AVHon/toolTube/README.md

Similar to tubes sold by
[McMaster-Carr](https://www.mcmaster.com/shipping-tubes/shape~round-tube/material~plastic/end-caps-included~yes/)
or
[Rose Lite Packaging](https://roselitepackaging.us/shop/plastic-tubes/adjustable-length-round-tubes)
.

If you clone this repository, don't forget to
`git submodule update --init --recursive`
to pull the [roundedRegularPolygon](https://github.com/AVHon/roundedRegularPolygon)
module that this project depends on.
