AVHon/toolTube/(commit log)

2020-07-10 Init: rounded polygons good, but tubes don't fit
    [RoundedRegularPolygon.scad, toolTube.scad]
2020-07-10 create thread profile as a module
    [toolTube.scad]
2020-07-10 only create inner tube
    [toolTube.scad]
2020-07-10 factor out tab_column; use OD; don't use radius
    [toolTube.scad]
2020-07-10 discard nonsense calculation of tab height
    [toolTube.scad]
2020-07-10 calculate tab heights using start<end range
    [toolTube.scad]
2020-07-10 factor out making of a tab
    [toolTube.scad]
2020-07-10 make threads fill whole surface
    [toolTube.scad]
2020-07-10 modularize inner part; make tabs not intercect cap
    [toolTube.scad]
2020-07-10 remove commented-out outer part
    [toolTube.scad]
2020-07-10 make outer part; TODOs might be done(!)
    [toolTube.scad]
2020-07-10 improve style; remove unnecessary lines
    [toolTube.scad]
2020-07-10 use a cube for the thread profile
    Rather than use 2 cones for the profile,
    use one cube turned up on its corners.
    This involves some tricky trigonometry
    to get the exact values of everything,
    but it is all angles and lengths on the
    unit cube.
    Upsides:
    * fewer lines of code
    * don't need to reset $fn
    * don't need to make 2 cones
    * assymetric angles
    * easier to put on
    * harder to fall off
    Downsides:
    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
    [toolTube.scad]
2020-07-10 flip thread direction on outer part
    [toolTube.scad]
2020-07-10 use approximations of trig values
    [toolTube.scad]
2020-07-10 do away with modifying $fn
    let it be the default,
    and round the roundedPolygon based on $fa
    [toolTube.scad]
2020-07-10 get the threads the right way around
    Argh, it must be too late/early. 7AM...
    [toolTube.scad]
2020-07-10 get the threads the right way again
    [toolTube.scad]
2020-07-10 remove all sets to $fn
    since it isn't necessary anymore.
    However, do respect it in non-cylinder parts
    in case somebody sets it and expects it to work.
    [toolTube.scad]
2020-07-10 refer to 'Thread' where correct
    [toolTube.scad]
2020-07-10 use list comprehension for making thread hulls
    The list comprehension is a more compact and more
    explicit way of generating the pairs of angles for
    each pair of hulled thread profiles.
    [toolTube.scad]
2020-07-10 use exact and eas[y|ier] trig for thread profile
    I learned about resize()!
    Rather than having to use trig, or magic numbers,
    to scale the cube to the right size, I can just
    resize it to whatever size I want! Much better!
    Since most trig is gone, and the result will now
    be exact, I decided to re-add the trig for rotating
    the cube to the right orientation. It's just one bit
    of trig, and it makes the whole thing come out exact.
    Also, since resize() scales the diameter, rather than
    the radius, I changed the comments and math in the
    constants section to reference the thread profile's
    diameter (id/15) rather than its radius (id/30).
    [toolTube.scad]
2020-07-10 use rotate([0,180]) instead of scale([-1,1,-1])
    For my purposes, rotating does the same thing,
    and its much easier to visualize than the scaling.
    [toolTube.scad]
2020-07-10 only use 1 cylinder (a cone) in the cap
    I realized that I was hull()ing two super-flat
    cylinders together, as though they were circles,
    and that I ought to just make a cylinder out of
    the two of them.
    [toolTube.scad]
2020-07-10 account for thickness of 3D-printed walls
    Haven't actually done this yet, even though
    it is vital to get the parts to actually work,
    and I think it is done and was easy to do.
    [toolTube.scad]
2020-07-10 clarify how thread pitch is calculated
    Technically, thread pitch should be calculated
    as a function of turns per axial length. Maybe
    I should switch to that in the future. In the
    meanwhile, the pitch angle works fine, but I felt
    I should not that it is calculated as a pitch
    when wrapped around the inside diameter.
    [toolTube.scad]
2020-07-10 allow Rounded Polygons to use $fa
    The number of sides will *always* be >= n
    If $fn is set, that will be used to make the poly
    If $fn is not set, $fa/360 will be used
    [RoundedRegularPolygon.scad]
2020-07-10 remove $fn and $fa from rounded polygon call
    Rounded Regular Polygon is now smart enough that
    it doesn't need to be given n.
    [toolTube.scad]
2020-07-10 Don't use maximum length, just use tube length
    Originally, ml would be the longest thing the tube
    could hold, and the 2 halves would be ml/2 long.
    The cap would add enough extra length for the two
    parts to overlap.
    The only thing that was done with ml was to divide
    id by 2 to get part height. Everything else was done
    with ph. So just use that, and rename it as Tube Length.
    [toolTube.scad]
2020-07-10 rename `Tube Length` to `Part Length`
    It was confusing for names starting with `t`
    to refer to both `Thread` and `Tube`.
    Now `Part` has the monopoly on the `p` prefix.
    [toolTube.scad]
2020-07-10 define origin of cap at bottom of cap
    Previously, the cap's origin was on its top face.
    Now that it is on the bottom, it can be built up
    more intuitively (fewer negatives, up from bottom)
    and also in fewer lines.
    [toolTube.scad]
2020-07-10 prioritize Part Length over Wall Thickness
    For people using this in the future, the length
    of the tubes is probably more interesting than
    the calculated wall thickness. Move it to be
    higher on the list of parameters.
    [toolTube.scad]
2020-07-10 move `nt` into tab_column()
    `nt` is the number of tabs in a column,
    and only the function that makes columns needs
    to know that.
    [toolTube.scad]
2020-07-10 fix comment: thread profile no longer approximate
    For a while, the thread profile was calculated with
    magic numbers which were rounded trig numbers
    calculated from the actual cube used for the
    profile.
    Now that the profile is made with the cube, an
    accurate call to rotate(), and resize(), it is no
    longer an approximation.
    [toolTube.scad]
2020-07-10 move inner tube up to floor
    Place the inner tube on the same level os the
    outer tube, with its lowest point at z=0.
    This may make a difference for some slicers.
    [toolTube.scad]
2020-07-10 get cap size with d=diamater, not r=diameter/2
    Mild oversight on my part, I forgot you could
    make cylinders with d1=x and d2=y, and I used
    r1=x/2 and r2=y/2 instead.
    [toolTube.scad]
2020-07-10 CAPITALIZE input parameters; they are like conts
    Other variables are calculated from them, but the
    parameters are by the user and not messed with.
    Capitalize them to clarify their role.
    [toolTube.scad]
2020-07-10 correct capitalization of variable names in comments
    [toolTube.scad]
2020-07-10 factor number of tabs per column to only call
    `nt` was calculated with other global variables,
    but it is only used by tab_column, which is only
    called by inner(). Moved the calculation inline
    to the call.
    [toolTube.scad]
2020-07-10 no more tabs, only threads
    It was only going to be confusing.
    Now that there is no tab_column,
    there might as well be nothing called "tabs".
    It's more correct anyway to call them "threads".
    [toolTube.scad]
2020-07-10 make outer spiral pitch from th, not tr
    This paves the way for making the thread pitch a
    parameter, calculating thread rise per degree in
    thread(), and removing some redundant trig.
    [toolTube.scad]
2020-07-10 threads are spirals. "spiral of threads"=confusing
    [toolTube.scad]
2020-07-10 use thread height instead of thread slope
    Using the height (or pitch) simplifies the
    geometry calculations and makes things more
    consistent.
    [toolTube.scad]
2020-07-10 lowercase names are nicer; move OD declaration
    UPPERCASE was getting annoying to look at.
    Also, after the geometry simplification, the only
    global variable that isn't a parameter is OD.
    Since it isn't needed except by inner() and
    outer(), I moved it to right before those. Now,
    all of the lines before the modules are either
    use<> or configurable parameters -- easier to
    edit without messing things up.
    [toolTube.scad]
2020-07-10 account for all of the walls in OD
    Just printed the first pair of pieces, and the
    outer piece is just barely too small to fit in.
    Realized that, across the entire cross-section,
    there are 4 wall thicknesses, and I probably need
    to double the offset allowance for walls.
    [toolTube.scad]
2020-07-10 ignore .STL files
2020-07-10 reverse thread slope for self-locking
    I found out that by flipping thread profile's
    cube, It is easier to push+twist the tube closed
    and to pull+twist it open, and also that it
    cinches shut when you close it on an object!
    [toolTube.scad]
2020-07-12 move part creation calls to top
    Since users will have to comment out one part or
    the other in order to get vase-mode-compatible
    STL files (only one object per STL), I put the
    calls up top, right below the parameters that
    users will also be modifying.
    OpenSCAD is happy to read variables that are
    defined and set later in the same scope, but I
    didn't want to do that, so I made inner()'s
    location based on `id` rather than `od`. This
    preserves the ability to read the file from top
    to bottom and see things defined, then used.
    [toolTube.scad]
2020-07-12 replace "Thread Height" with "Thread Pitch"
    "Pitch" is the correfct technical term for what
    I've been calling the "Height". Also, it's easier
    to search-and-replace.
    [toolTube.scad]
2020-07-12 calculate thread pitch from diameter
    rather than making it a configurable parameter.
    The old default of 6mm was okay for very narrow
    tubes, but too fine for larger tubes. Better to
    have a good ratio and calculate it against the
    parameter that the user actually knows (how wide
    they need the tube to be) then making them have
    to fiddle with another parameter.
    Users who think the pitch is too coarse or too
    fine can adjust the denominator in the fraction.
    [toolTube.scad]
2020-07-12 make thread pitch coarser
    The test parts I've made seem to all require a
    little too much twisting, and not enought pulling
    or pushing, to open or close.
    [toolTube.scad]
2020-07-12 correct comment capitalization
    [toolTube.scad]
2020-07-12 simplify thread creation
    The process is the same, but the math has been
    factored.
    [toolTube.scad]
2020-07-12 loop-ify thread creation
    [toolTube.scad]
2020-07-12 re-index thread column height
    As a matter of preference, I think 0-based
    indexing is easier to understand here.
    [toolTube.scad]
2020-07-12 clarify comment
    [toolTube.scad]
2020-07-12 Add instructions for vase/spiralize STL export
    Slic3r's "Vase Mode" and Cura's "Spiralized Mode"
    both require that the printer only have 1 object
    on the bed in order to work. To avoid having to
    split STLs into multiple parts, users can comment
    out one part or the other and export as 2 STLs
    directly from OpenSCAD.
    Maybe I should make this a boolean or something,
    that produces the user-chosen part?
    [toolTube.scad]
2020-07-12 make rounded corners slightly tighter
    Some of the tubes I've printed roll a little
    [toolTube.scad]
2020-07-12 simplify code blocks in RoundedRegularPolygon
    Code is basically the same complexity, but it is
    now visually simpler (and narrower).
    [RoundedRegularPolygon.scad]
2020-07-12 add comment documenting $fa
    [RoundedRegularPolygon.scad]
2020-07-20 Make parameters work with Customizer
    [toolTube.scad]
2020-07-20 Simplify thread creation
    [toolTube.scad]
2020-07-20 simplify inside's thread creation
    [toolTube.scad]
2020-07-20 rename "Part Length" to Length. Simplify cap creation
    [toolTube.scad]
2020-07-20 slight variable reorganization. Change-by-one.
    [toolTube.scad]
2020-07-20 un-factored thread module
    [toolTube.scad]
2020-07-20 spacing consistency
    [toolTube.scad]
2020-07-20 un-factored (un-modularized) inside and outside parts
    [toolTube.scad]
2020-07-20 don't have 2 variables named `l`
    [toolTube.scad]
2020-07-20 don't make outside whenever inside is made
    [toolTube.scad]
2020-07-20 better comments
    [toolTube.scad]
2020-07-20 consistent indedtation
    [toolTube.scad]
2020-07-20 Descriptive comment at top
    [toolTube.scad]
2020-07-20 better comments. simpler "extra side?" function
    [RoundedRegularPolygon.scad]
2020-07-20 update date
    [RoundedRegularPolygon.scad]
2020-07-20 lowercase file name of rounded regular polygon
    [roundedRegularPolygon.scad, toolTube.scad]
2020-07-21 Moved roundedRegularPolygon to submodule
    [roundedRegularPolygon.scad]
2020-08-01 add proper path to roundedRegularPolygon import
    [toolTube.scad]
2020-08-01 fixed roundedRolygon path. removed spurious `#`
    [toolTube.scad]
